dsosahaby/spartan_fc/images/get_in.jpeg

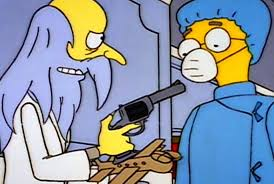
images/get_in.jpeg
