dsosahaby/spartan_fc/README.md

# spartan_fc

Quadcopter flight controller hardware for betaflight firmware
