dsosahaby/spartan_fc/spartan_mk1/spartan_mk1.kicad_pcb

## KiCad design spartan_mk1/spartan_mk1.kicad_pcb (2020-11-09)

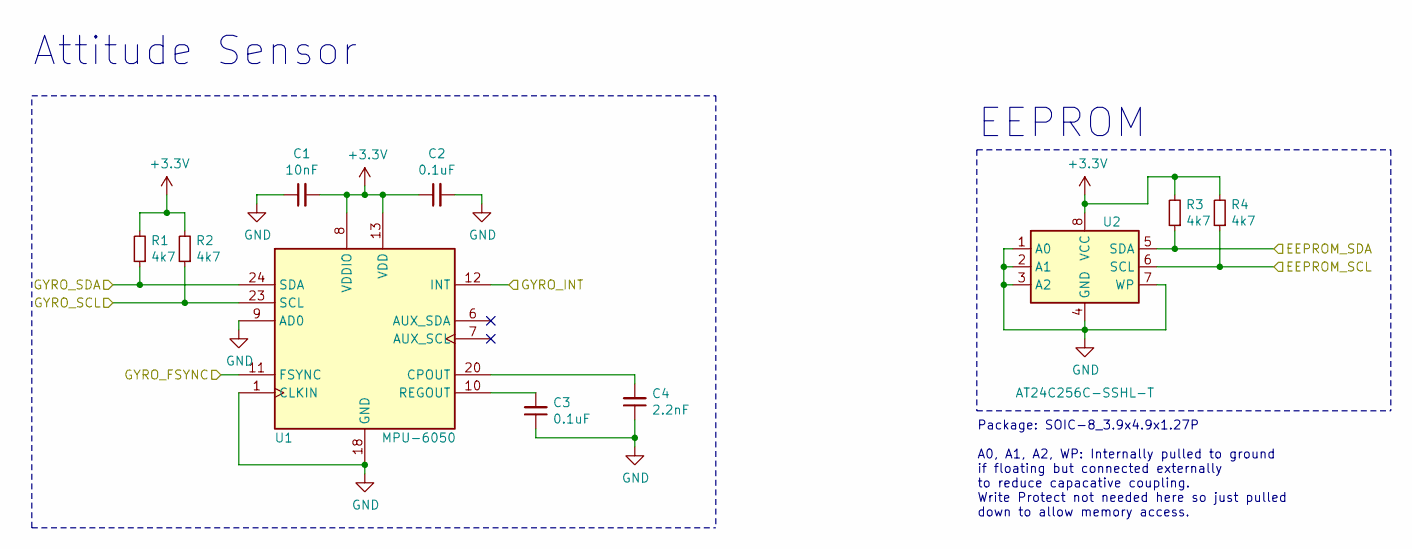
[picture p2: schematic peripherals.sch]

Parts:
C1: 10nF; C_0402_1005Metric; LCSC Part # C15195
C2, C3: 0.1uF; C_0402_1005Metric; LCSC Part # C1525
C4: 2.2nF; C_0402_1005Metric; LCSC Part # C1531
R1, R2, R3, R4: 4k7; R_0402_1005Metric; LCSC Part # C25900
U1: MPU-6050; InvenSense_QFN-24_4x4mm_P0.5mm; LCSC Part # C24112
U2: AT24C256C-SSHL-T; SOIC-8_3.9x4.9mm_P1.27mm

Connections:
+3V3: C1.2, C2.1, R1.2, R2.2, R3.2, R4.2, U1.8 (VDDIO), U1.13 (VDD), U2.8 (VCC); also elsewhere on the board
/EEPROM_SCL: R4.1, U2.6 (SCL); also elsewhere on the board
/EEPROM_SDA: R3.1, U2.5 (SDA); also elsewhere on the board
/GYRO_FSYNC: U1.11 (FSYNC); also elsewhere on the board
/GYRO_INT: U1.12 (INT); also elsewhere on the board
/GYRO_SCL: R2.1, U1.23 (SCL); also elsewhere on the board
/GYRO_SDA: R1.1, U1.24 (SDA); also elsewhere on the board
GND: C1.1, C2.2, C3.1, C4.1, U1.1 (CLKIN), U1.9 (AD0), U1.18 (GND), U2.1 (A0), U2.2 (A1), U2.3 (A2), U2.4 (GND), U2.7 (WP); also elsewhere on the board
unnamed: C3.2, U1.10 (REGOUT)
unnamed: C4.2, U1.20 (CPOUT)

Notes on the sheet:
Attitude Sensor
EEPROM
Package: SOIC-8_3.9x4.9x1.27P A0, A1, A2, WP: Internally pulled to ground if floating but connected externally to reduce capacative coupling. Write Protect not needed here so just pulled down to allow memory access.

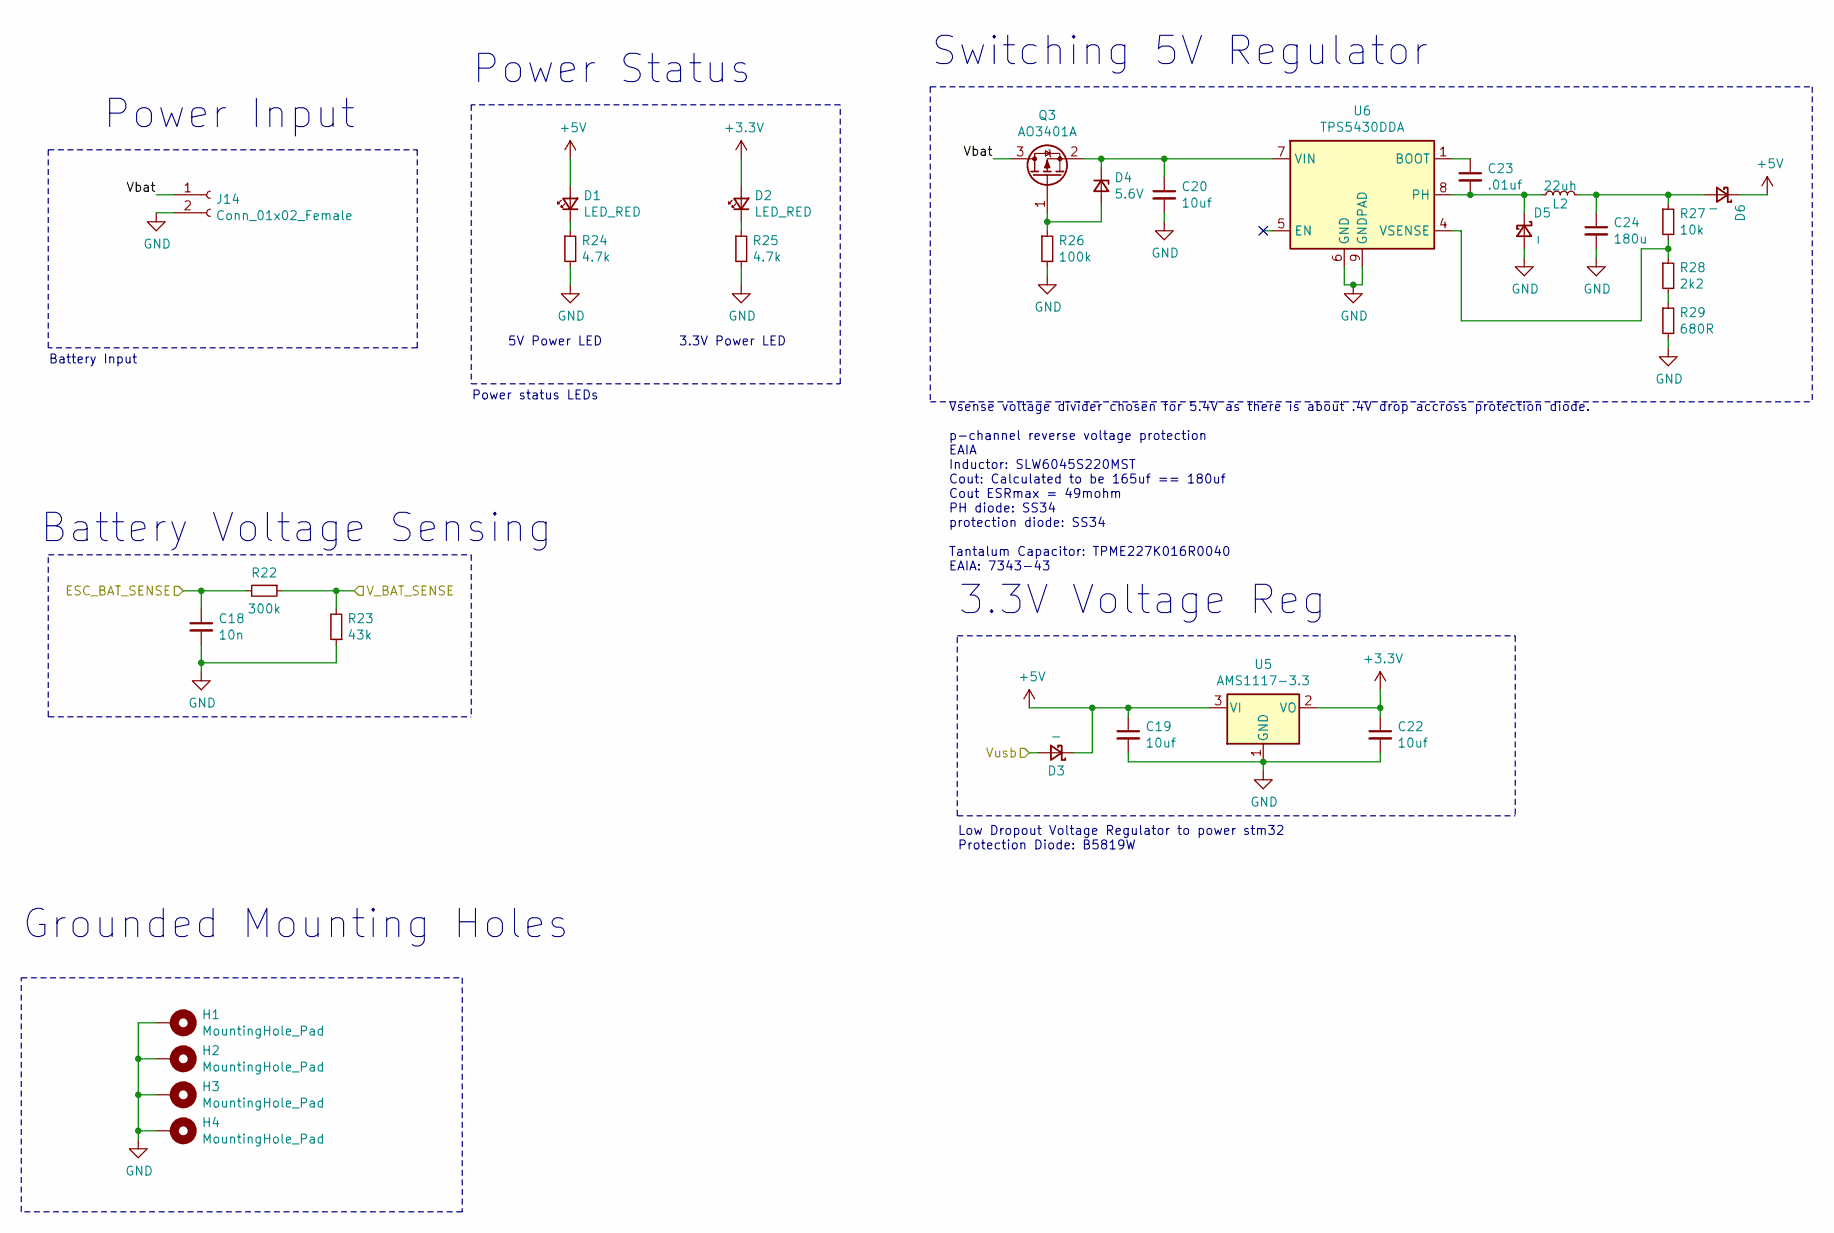
[picture p3: schematic Power_Regulation.sch]

Parts:
C18: 10n; C_0603_1608Metric; LCSC Part # C57112
C19: 10uf; C_0805_2012Metric; LCSC Part # C15850
C20: 10uf; C_1206_3216Metric; LCSC Part # C13585
C22: 10uf; C_0603_1608Metric; LCSC Part # C19702
C23: .01uf; C_0402_1005Metric; LCSC Part # C15195
C24: 180u; CP_EIA-7343-43
D1, D2: LED_RED; LED_0603_1608Metric; LCSC Part # C2286
D3: _; D_SOD-123; LCSC Part # C8598
D4: 5.6V; D_MiniMELF; LCSC Part # C8062
D5, D6: _; D_SMA; LCSC Part # C8678
H1, H2, H3, H4: MountingHole_Pad; MountingHole_3.2mm_M3_Pad_Via
J14: Conn_01x02_Female; 01x02_3mm
L2: 22uh; SLW6045_6mmX6mm; LCSC Part # C206321
Q3: AO3401A; SOT-23; LCSC Part # C15127
R22: 300k; R_0603_1608Metric; LCSC Part # C23024
R23: 43k; R_0603_1608Metric; LCSC Part # C23172
R24, R25: 4.7k; R_0402_1005Metric; LCSC Part # C25900
R26: 100k; R_0805_2012Metric; LCSC Part # C17407
R27: 10k; R_0402_1005Metric; LCSC Part # C25744
R28: 2k2; R_0402_1005Metric; LCSC Part # C25879
R29: 680R; R_0402_1005Metric; LCSC Part # C25130
U5: AMS1117-3.3; SOT-223-3_TabPin2; LCSC Part # C6186
U6: TPS5430DDA; TI_SO-PowerPAD-8_ThermalVias; LCSC Part # C9864

Connections:
+3V3: C22.1, D2.2 (A), U5.2 (VO); also elsewhere on the board
+5V: C19.1, D1.2 (A), D3.1 (K), D6.1 (K), U5.3 (VI); also elsewhere on the board
/ESC_BAT_SENSE: C18.1, R22.2; also elsewhere on the board
/Power_Regulation/Vbat: J14.1, Q3.3 (D)
/V_BAT_SENSE: R22.1, R23.2; also elsewhere on the board
/V_USB: D3.2 (A); also elsewhere on the board
GND: C18.2, C19.2, C20.2, C22.2, C24.2, D5.2 (A), H1.1, H2.1, H3.1, H4.1, J14.2, R23.1, R24.2, R25.2, R26.2, R29.2, U5.1 (GND), U6.6 (GND), U6.9 (GNDPAD); also elsewhere on the board
unnamed: C20.1, D4.1 (K), Q3.2 (S), U6.7 (VIN)
unnamed: C23.1, U6.1 (BOOT)
unnamed: C23.2, D5.1 (K), L2.1, U6.8 (PH)
unnamed: C24.1, D6.2 (A), L2.2, R27.1
unnamed: D1.1 (K), R24.1
unnamed: D2.1 (K), R25.1
unnamed: D4.2 (A), Q3.1 (G), R26.1
unnamed: R27.2, R28.1, U6.4 (VSENSE)
unnamed: R28.2, R29.1

Notes on the sheet:
Battery Input
Low Dropout Voltage Regulator to power stm32 Protection Diode: B5819W
Vsense voltage divider chosen for 5.4V as there is about .4V drop accross protection diode. p-channel reverse voltage protection EAIA Inductor: SLW6045S220MST Cout: Calculated to be 165uf == 180uf Cout ESRmax = 49mohm PH diode: SS34 protection diode: SS34 Tantalum Capacitor: TPME227K016R0040 EAIA: 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
3.3V Power LED
5V Power LED
Power status LEDs
Switching 5V Regulator
3.3V Voltage Reg
Power Input
Power Status
Battery Voltage Sensing
Grounded Mounting Holes

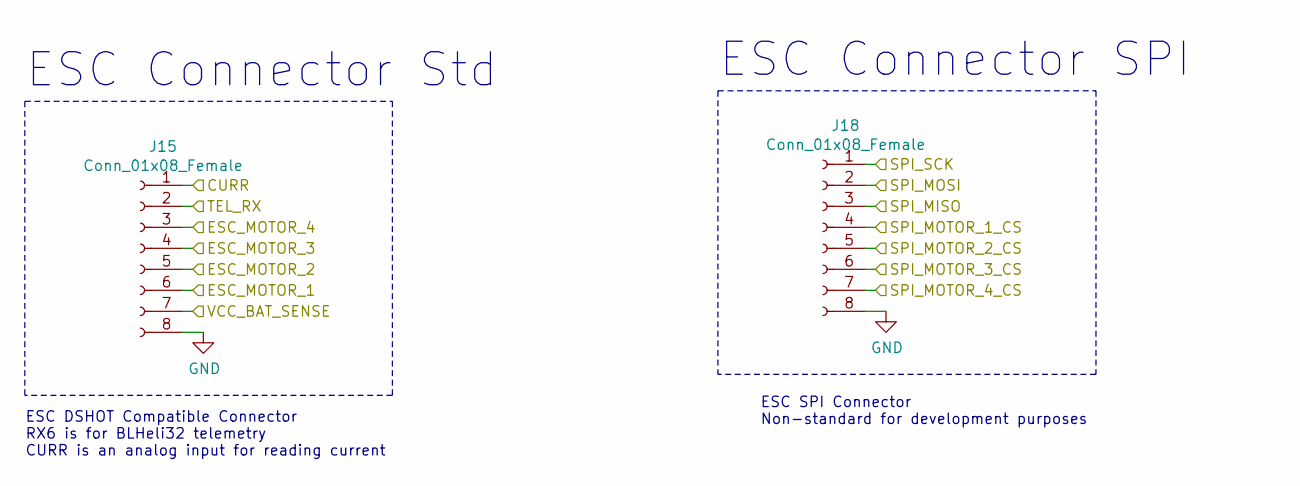
[picture p4: schematic ESC_Connection.sch]

Parts:
J15, J18: Conn_01x08_Female; JST_SH_BM08B-SRSS-TB_1x08-1MP_P1.00mm_Vertical

Connections:
/CURR_SENSE: J15.1; also elsewhere on the board
/ESC_1_CS: J18.4; also elsewhere on the board
/ESC_2_CS: J18.5; also elsewhere on the board
/ESC_3_CS: J18.6; also elsewhere on the board
/ESC_4_CS: J18.7; also elsewhere on the board
/ESC_BAT_SENSE: J15.7; also elsewhere on the board
/ESC_DSHOT_1: J15.6; also elsewhere on the board
/ESC_DSHOT_2: J15.5; also elsewhere on the board
/ESC_DSHOT_3: J15.4; also elsewhere on the board
/ESC_DSHOT_4: J15.3; also elsewhere on the board
/SPI_ESC_MISO: J18.3; also elsewhere on the board
/SPI_ESC_MOSI: J18.2; also elsewhere on the board
/SPI_ESC_SCK: J18.1; also elsewhere on the board
/UART3_RX: J15.2; also elsewhere on the board
GND: J15.8, J18.8; also elsewhere on the board

Notes on the sheet:
ESC DSHOT Compatible Connector RX6 is for BLHeli32 telemetry CURR is an analog input for reading current
ESC Connector Std
ESC Connector SPI
ESC SPI Connector Non-standard for development purposes

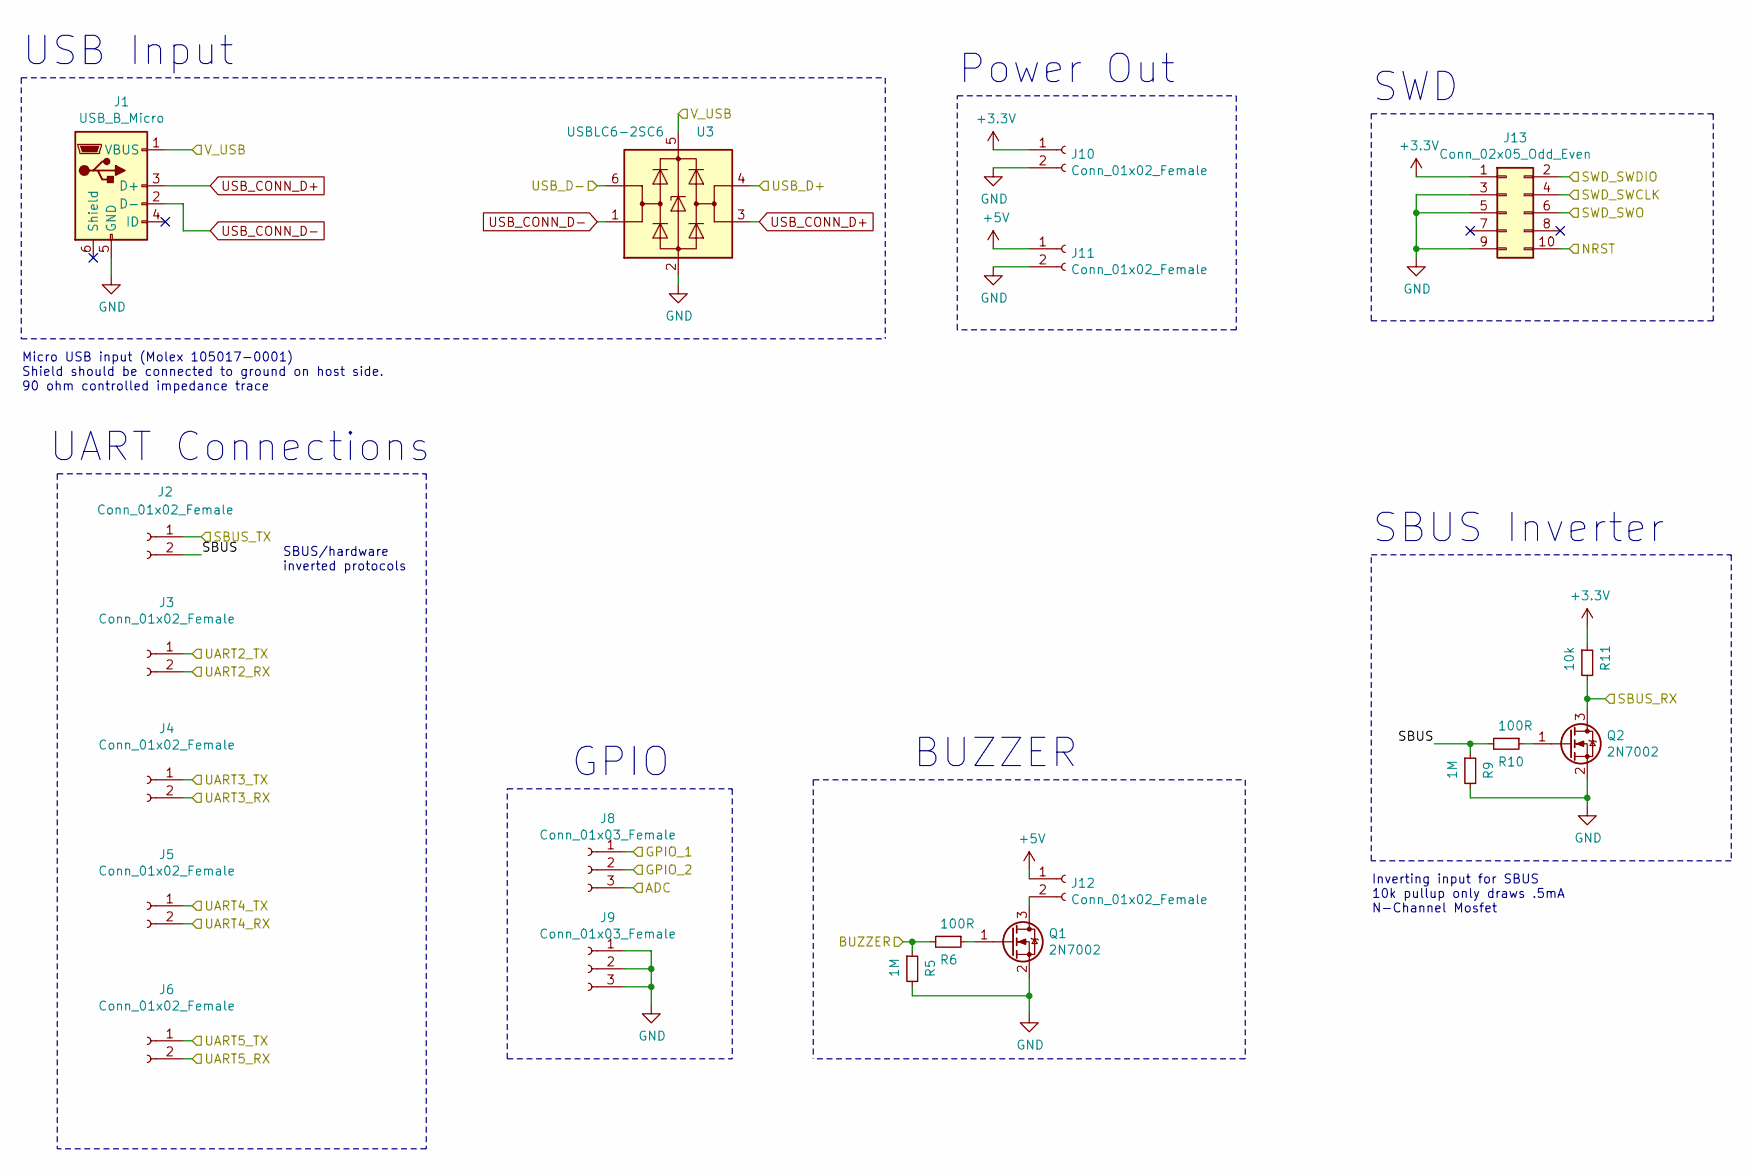
[picture p5: schematic Inputs.sch]

Parts:
J1: USB_B_Micro; USB_Micro-B_Molex-105017-0001
J2, J3, J4, J5, J6, J10, J12: Conn_01x02_Female; 01x02_1.5mm
J8, J9: Conn_01x03_Female; 01x03_1.5mm
J11: Conn_01x02_Female; 01x02_3mm
J13: Conn_02x05_Odd_Even; PinHeader_2x05_P1.27mm_Vertical_SMD
Q1, Q2: 2N7002; SOT-23; LCSC Part # C8545
R5, R9: 1M; R_0402_1005Metric; LCSC Part # C26083
R6, R10: 100R; R_0805_2012Metric; LCSC Part # C17408
R11: 10k; R_0402_1005Metric; LCSC Part # C25744
U3: USBLC6-2SC6; SOT-23-6; LCSC Part # C7519

Connections:
+3V3: J10.1, J13.1, R11.1; also elsewhere on the board
+5V: J11.1, J12.1; also elsewhere on the board
/BUZZER: R5.1, R6.2; also elsewhere on the board
/GEN_ADC: J8.3; also elsewhere on the board
/GPIO_1: J8.1; also elsewhere on the board
/GPIO_2: J8.2; also elsewhere on the board
/Inputs/SBUS: J2.2, R9.1, R10.2
/NRST: J13.10; also elsewhere on the board
/SBUS_RX: Q2.3 (D), R11.2; also elsewhere on the board
/SBUS_TX: J2.1; also elsewhere on the board
/SWCLK: J13.4; also elsewhere on the board
/SWDIO: J13.2; also elsewhere on the board
/SWO: J13.6; also elsewhere on the board
/UART2_RX: J3.2; also elsewhere on the board
/UART2_TX: J3.1; also elsewhere on the board
/UART3_RX: J4.2; also elsewhere on the board
/UART3_TX: J4.1; also elsewhere on the board
/UART4_RX: J5.2; also elsewhere on the board
/UART4_TX: J5.1; also elsewhere on the board
/UART5_RX: J6.2; also elsewhere on the board
/UART5_TX: J6.1; also elsewhere on the board
/USB_D+: U3.4 (I/O2); also elsewhere on the board
/USB_D-: U3.6 (I/O1); also elsewhere on the board
/V_USB: J1.1 (VBUS), U3.5 (VBUS); also elsewhere on the board
GND: J1.5 (GND), J9.1, J9.2, J9.3, J10.2, J11.2, J13.3, J13.5, J13.9, Q1.2 (S), Q2.2 (S), R5.2, R9.2, U3.2 (GND); also elsewhere on the board
unnamed: J12.2, Q1.3 (D)
unnamed: Q1.1 (G), R6.1
unnamed: Q2.1 (G), R10.1
USB_CONN_D+: J1.3 (D+), U3.3 (I/O2)
USB_CONN_D-: J1.2 (D-), U3.1 (I/O1)

Notes on the sheet:
Micro USB input (Molex 105017-0001) Shield should be connected to ground on host side. 90 ohm controlled impedance trace
Inverting input for SBUS 10k pullup only draws .5mA N-Channel Mosfet
SBUS Inverter
USB Input
SBUS/hardware inverted protocols
UART Connections
GPIO
Power Out
SWD
BUZZER

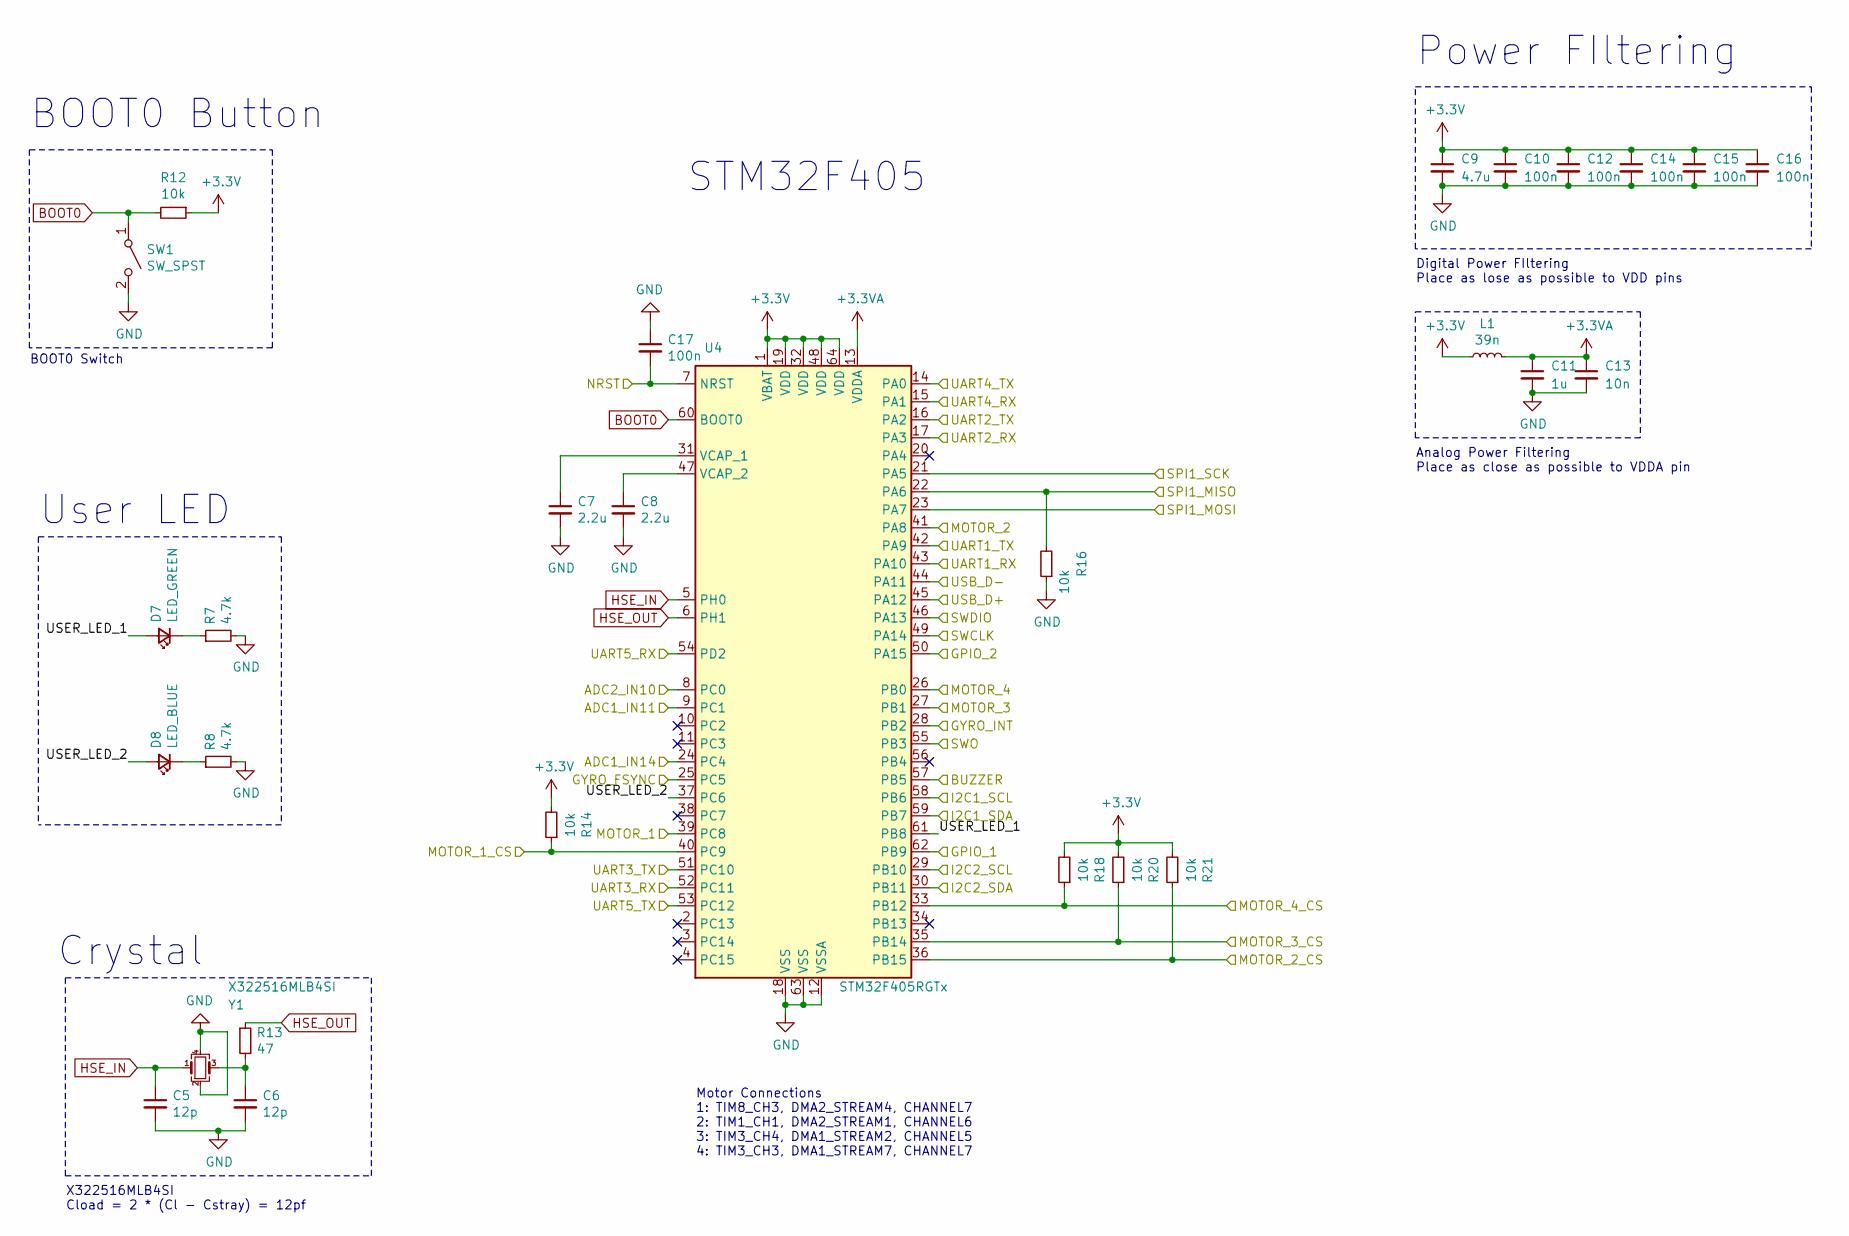
[picture p6: schematic stm32_controller.sch]

Parts:
C5, C6: 12p; C_0402_1005Metric; LCSC Part # C1547
C7, C8: 2.2u; C_0603_1608Metric; LCSC Part # C12530
C9: 4.7u; C_0402_1005Metric; LCSC Part # C23733
C10, C12, C14, C15, C16, C17: 100n; C_0402_1005Metric; LCSC Part # C1525
C11: 1u; C_0402_1005Metric; LCSC Part # C52923
C13: 10n; C_0402_1005Metric; LCSC Part # C15195
D7: LED_GREEN; LED_0603_1608Metric; LCSC Part # C205443
D8: LED_BLUE; LED_0603_1608Metric; LCSC Part # C72041
L1: 39n; L_0402_1005Metric; LCSC Part # C18830
R7, R8: 4.7k; R_0402_1005Metric; LCSC Part # C25900
R12, R14, R16, R18, R20, R21: 10k; R_0402_1005Metric; LCSC Part # C25744
R13: 47; R_0402_1005Metric; LCSC Part # C25118
SW1: SW_SPST; SW_B3U-3000P
U4: STM32F405RGTx; LQFP-64_10x10mm_P0.5mm; LCSC Part # C15742
Y1: X322516MLB4SI; Crystal_SMD_3225-4Pin_3.2x2.5mm; LCSC Part # C13738

Connections:
+3.3VA: C11.1, C13.1, L1.2, U4.13 (VDDA)
+3V3: C9.1, C10.1, C12.1, C14.1, C15.1, C16.1, L1.1, R12.1, R14.2, R18.2, R20.2, R21.2, U4.1 (VBAT), U4.19 (VDD), U4.32 (VDD), U4.48 (VDD), U4.64 (VDD); also elsewhere on the board
/BUZZER: U4.57 (PB5); also elsewhere on the board
/CURR_SENSE: U4.8 (PC0); also elsewhere on the board
/EEPROM_SCL: U4.29 (PB10); also elsewhere on the board
/EEPROM_SDA: U4.30 (PB11); also elsewhere on the board
/ESC_1_CS: R14.1, U4.40 (PC9); also elsewhere on the board
/ESC_2_CS: R21.1, U4.36 (PB15); also elsewhere on the board
/ESC_3_CS: R20.1, U4.35 (PB14); also elsewhere on the board
/ESC_4_CS: R18.1, U4.33 (PB12); also elsewhere on the board
/ESC_DSHOT_1: U4.39 (PC8); also elsewhere on the board
/ESC_DSHOT_2: U4.41 (PA8); also elsewhere on the board
/ESC_DSHOT_3: U4.27 (PB1); also elsewhere on the board
/ESC_DSHOT_4: U4.26 (PB0); also elsewhere on the board
/GEN_ADC: U4.9 (PC1); also elsewhere on the board
/GPIO_1: U4.62 (PB9); also elsewhere on the board
/GPIO_2: U4.50 (PA15); also elsewhere on the board
/GYRO_FSYNC: U4.25 (PC5); also elsewhere on the board
/GYRO_INT: U4.28 (PB2); also elsewhere on the board
/GYRO_SCL: U4.58 (PB6); also elsewhere on the board
/GYRO_SDA: U4.59 (PB7); also elsewhere on the board
/NRST: C17.2, U4.7 (NRST); also elsewhere on the board
/SBUS_RX: U4.42 (PA9); also elsewhere on the board
/SBUS_TX: U4.43 (PA10); also elsewhere on the board
/SPI_ESC_MISO: R16.2, U4.22 (PA6); also elsewhere on the board
/SPI_ESC_MOSI: U4.23 (PA7); also elsewhere on the board
/SPI_ESC_SCK: U4.21 (PA5); also elsewhere on the board
/STM32 Controller/USER_LED_1: D7.2 (A), U4.61 (PB8)
/STM32 Controller/USER_LED_2: D8.2 (A), U4.37 (PC6)
/SWCLK: U4.49 (PA14); also elsewhere on the board
/SWDIO: U4.46 (PA13); also elsewhere on the board
/SWO: U4.55 (PB3); also elsewhere on the board
/UART2_RX: U4.17 (PA3); also elsewhere on the board
/UART2_TX: U4.16 (PA2); also elsewhere on the board
/UART3_RX: U4.52 (PC11); also elsewhere on the board
/UART3_TX: U4.51 (PC10); also elsewhere on the board
/UART4_RX: U4.15 (PA1); also elsewhere on the board
/UART4_TX: U4.14 (PA0); also elsewhere on the board
/UART5_RX: U4.53 (PC12); also elsewhere on the board
/UART5_TX: U4.54 (PD2); also elsewhere on the board
/USB_D+: U4.45 (PA12); also elsewhere on the board
/USB_D-: U4.44 (PA11); also elsewhere on the board
/V_BAT_SENSE: U4.24 (PC4); also elsewhere on the board
BOOT0: R12.2, SW1.1 (A), U4.60 (BOOT0)
GND: C5.2, C6.2, C7.2, C8.2, C9.2, C10.2, C11.2, C12.2, C13.2, C14.2, C15.2, C16.2, C17.1, R7.2, R8.2, R16.1, SW1.2 (B), U4.12 (VSSA), U4.18 (VSS), U4.63 (VSS), Y1.2, Y1.4; also elsewhere on the board
HSE_IN: C5.1, U4.5 (PH0), Y1.1
HSE_OUT: R13.1, U4.6 (PH1)
unnamed: C6.1, R13.2, Y1.3
unnamed: C7.1, U4.31 (VCAP_1)
unnamed: C8.1, U4.47 (VCAP_2)
unnamed: D7.1 (K), R7.1
unnamed: D8.1 (K), R8.1

Notes on the sheet:
X322516MLB4SI Cload = 2 * (Cl - Cstray) = 12pf
BOOT0 Switch
Digital Power FIltering Place as lose as possible to VDD pins
Analog Power Filtering Place as close as possible to VDDA pin
Power FIltering
Crystal
BOOT0 Button
STM32F405
Motor Connections 1: TIM8_CH3, DMA2_STREAM4, CHANNEL7 2: TIM1_CH1, DMA2_STREAM1, CHANNEL6 3: TIM3_CH4, DMA1_STREAM2, CHANNEL5 4: TIM3_CH3, DMA1_STREAM7, CHANNEL7
User LED

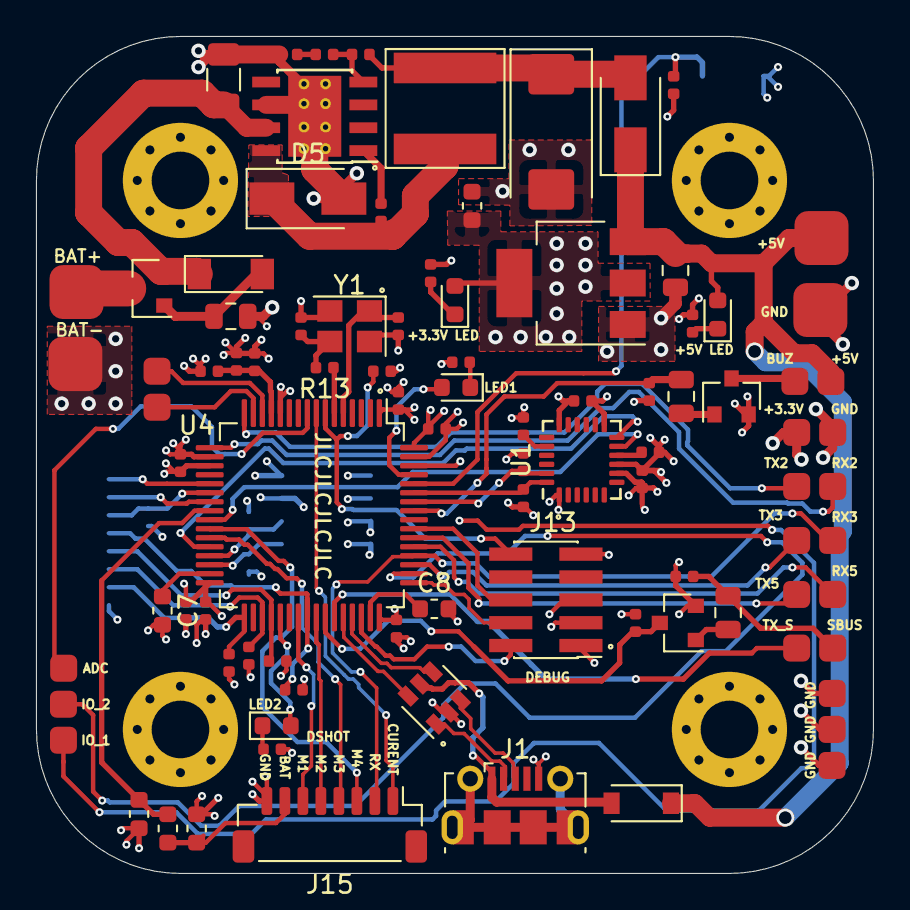
[picture p7: board spartan_mk1.kicad_pcb from above]

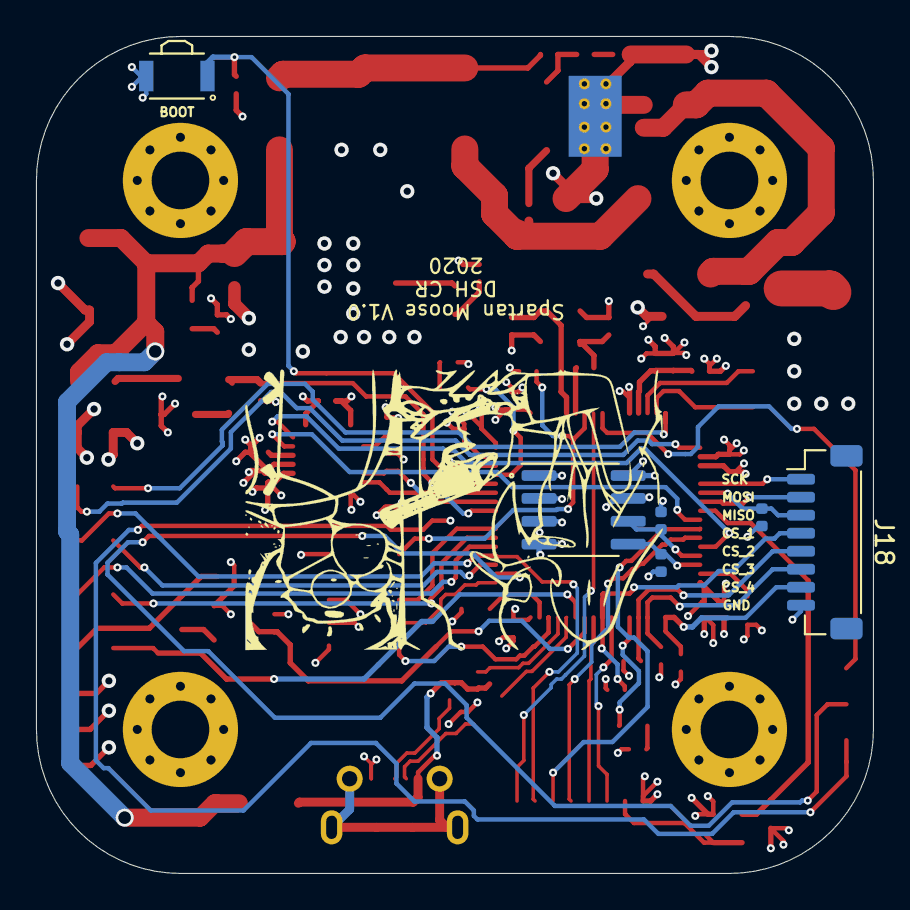
[picture p8: board spartan_mk1.kicad_pcb from below]

Board: 4 copper layers, 46.5 x 46.5 mm, 89 parts (6 on the bottom side), 73 nets.
