dsosahaby/spartan_fc/(commit log)

2020-10-18 added main pcb design
    [ESC_Connection.sch, Inputs_outputs.sch, peripherals.sch, power.sch, serial_communication.sch, spartan_mk1.kicad_pcb, spartan_mk1.sch, stm32_controller.sch]
2020-10-19 Added ESC connectors in schematic
    [ESC_Connection.sch, spartan_mk1.sch]
2020-10-24 Complete schematic with DRC done
    [ESC_Connection.sch, Inputs.sch, Power_Regulation.sch, peripherals.sch, serial_communication.sch, spartan_mk1.sch, stm32_controller.sch]
2020-10-26 Footprints added started PCB placement
    [ESC_Connection.sch, Inputs.sch, Power_Regulation.sch, peripherals.sch, stm32_controller.sch]
2020-10-28 Changed offboard connections to SMD pads for space
    [spartan_mk1.kicad_pcb]
2020-10-30 Almost complete PCB layout (no routing)
    [ESC_Connection.sch, Power_Regulation.sch, spartan_mk1.kicad_pcb, stm32_controller.sch]
2020-11-01 updated placement
    [Inputs.sch, Power_Regulation.sch, spartan_mk1.sch, stm32_controller.sch]
2020-11-02 Routing in progress
    [ESC_Connection.sch, Inputs.sch, Power_Regulation.sch, spartan_mk1.kicad_pcb, spartan_mk1.sch, stm32_controller.sch]
2020-11-02 Almost complete routing
    [spartan_mk1.kicad_pcb]
2020-11-03 Updated routing. ALMOST done
    [spartan_mk1.kicad_pcb]
2020-11-04 Improved grounding vias and fixed filter capacitor ground routing
    [spartan_mk1.kicad_pcb]
2020-11-05 Routing complete. Passed DRC
    [spartan_mk1.kicad_pcb, stm32_controller.sch]
2020-11-07 Routing complete. Labels complete
    [spartan_mk1.kicad_pcb, stm32_controller.sch]
2020-11-07 Updated LED labels
    [spartan_mk1.kicad_pcb]
2020-11-09 Generated gerber files. Positions and BOM assemly files generated
    [Inputs.sch, Power_Regulation.sch, peripherals.sch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]
2020-11-09 Complete assembly and gerber. Small rotational errors in position file
    [spartan_mk1-B_Cu.gbr, spartan_mk1-B_Mask.gbr, spartan_mk1-B_Paste.gbr, spartan_mk1-B_SilkS.gbr, spartan_mk1-Edge_Cuts.gbr, spartan_mk1-F_Cu.gbr, spartan_mk1-F_Mask.gbr, spartan_mk1-F_Paste.gbr]
